crazytiti/Treuil-Handi/code_arduino/simuler le treuil/servo1.png

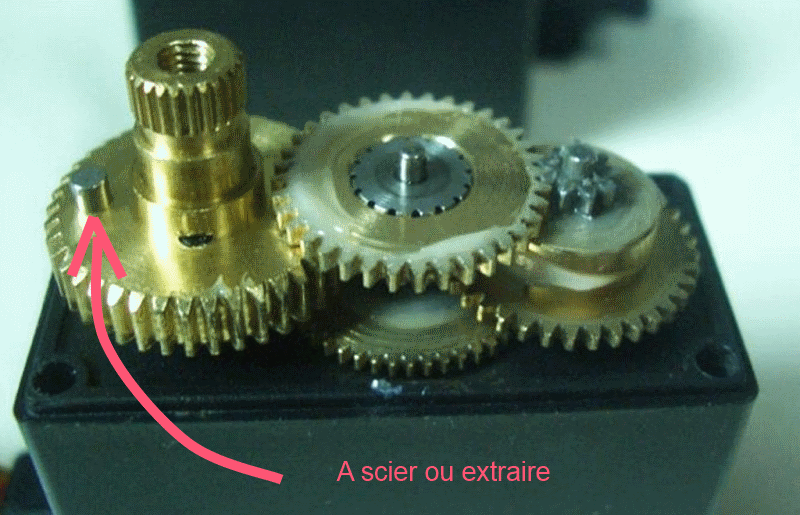
code_arduino/simuler le treuil/servo1.png
