crazytiti/Treuil-Handi/doc/HBridge_exemple.png

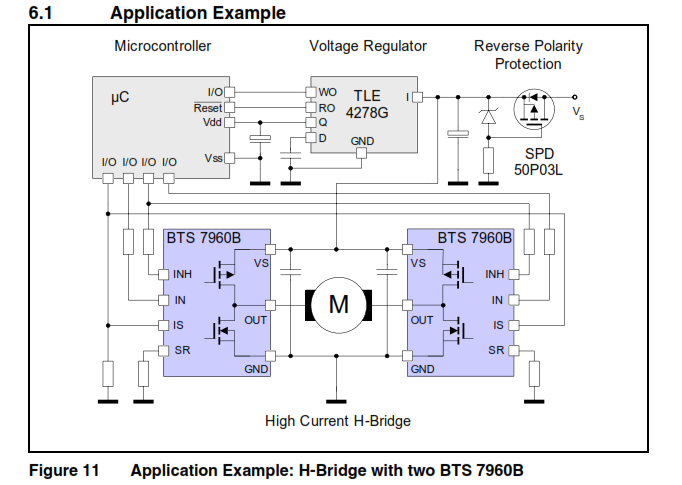
doc/HBridge_exemple.png
