crazytiti/Treuil-Handi/images/FR4.png

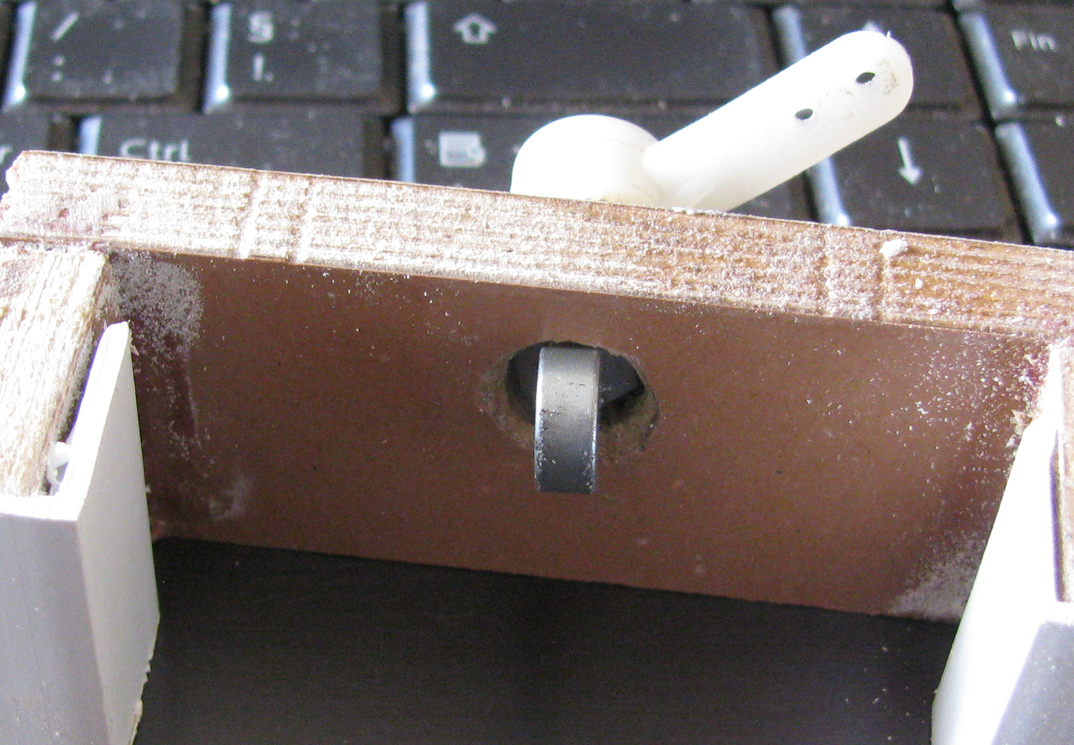
images/FR4.png
