crazytiti/Treuil-Handi/images/FR5.png

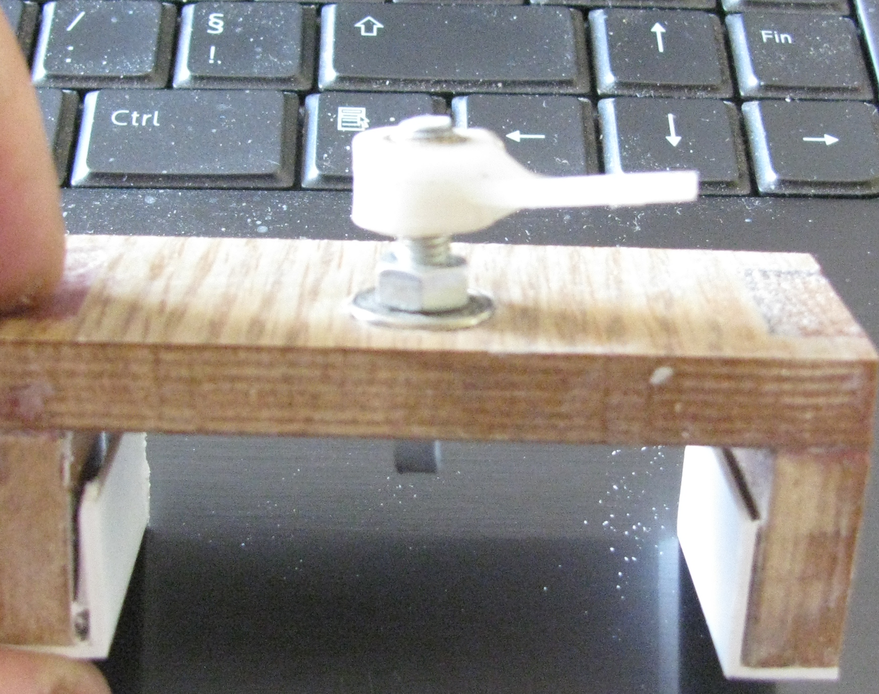
images/FR5.png
