crazytiti/Treuil-Handi/images/proto-board/aimants.jpg

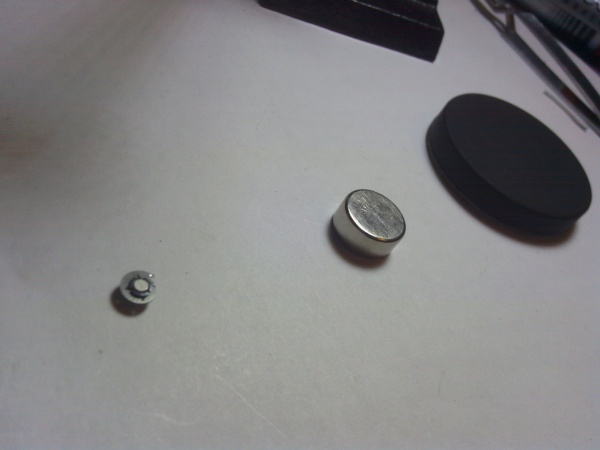
images/proto-board/aimants.jpg
