crazytiti/Treuil-Handi/images/proto-board/capteur_soude.jpg

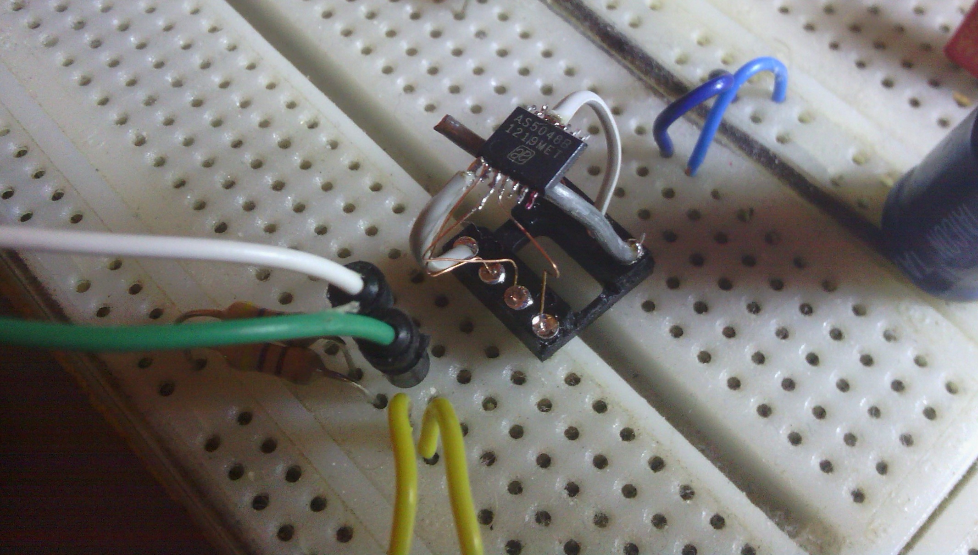
images/proto-board/capteur_soude.jpg
