crazytiti/Treuil-Handi/images/proto-board/it_work.jpg

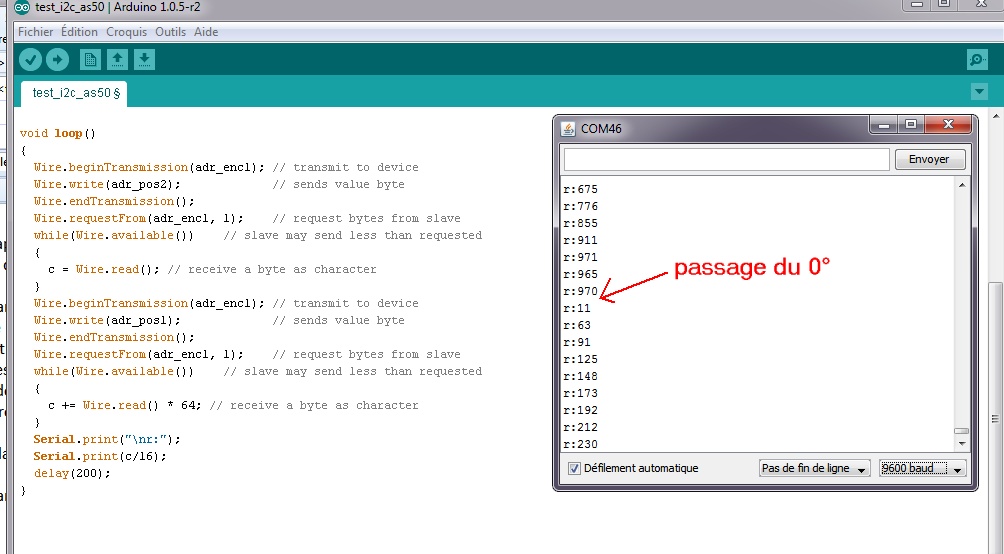
images/proto-board/it_work.jpg
