crazytiti/Treuil-Handi/images/proto-board/potar_proto.jpg

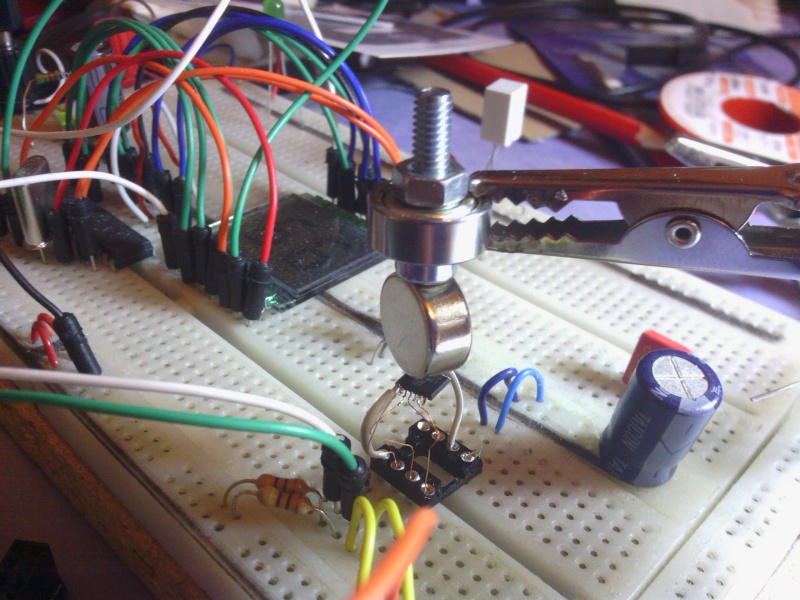
images/proto-board/potar_proto.jpg
