crazytiti/Treuil-Handi/images/proto/proto_treuil_visseuse-1.jpg

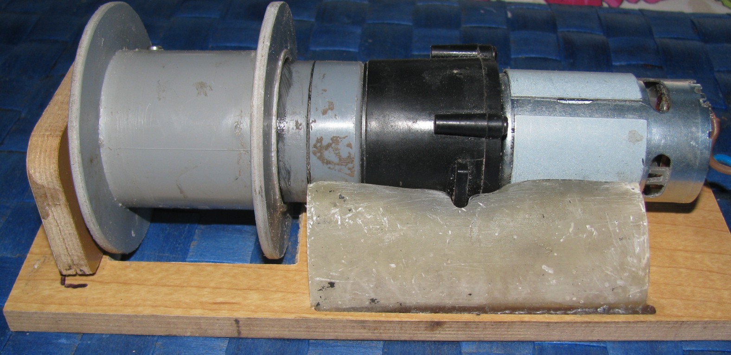
images/proto/proto_treuil_visseuse-1.jpg
