crazytiti/Treuil-Handi/images/proto/proto_treuil_visseuse-2.jpg

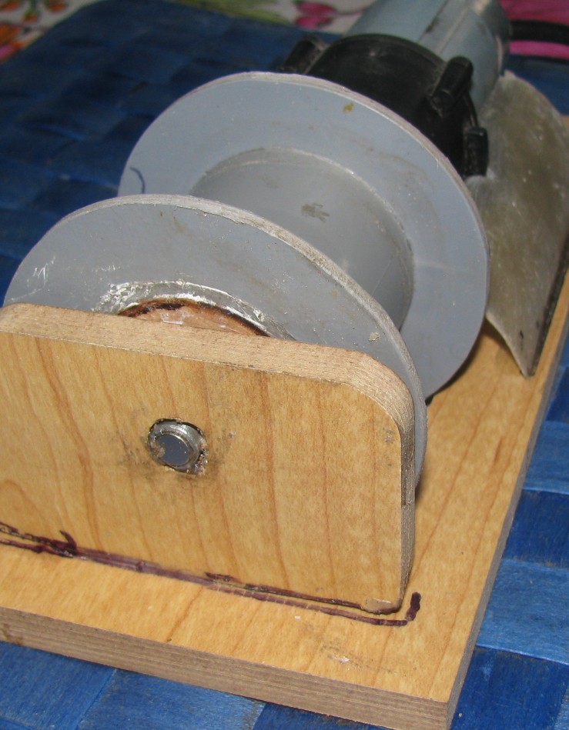
images/proto/proto_treuil_visseuse-2.jpg
