crazytiti/Treuil-Handi/images/proto/treuil.jpg

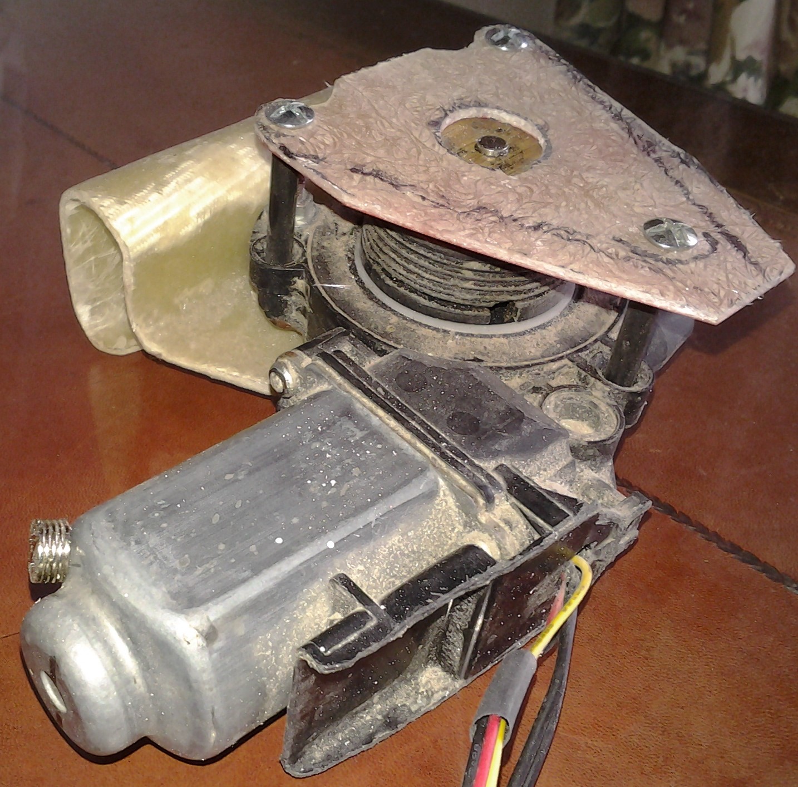
images/proto/treuil.jpg
