crazytiti/Treuil-Handi/schema-pcb/Arduino micro 1.png

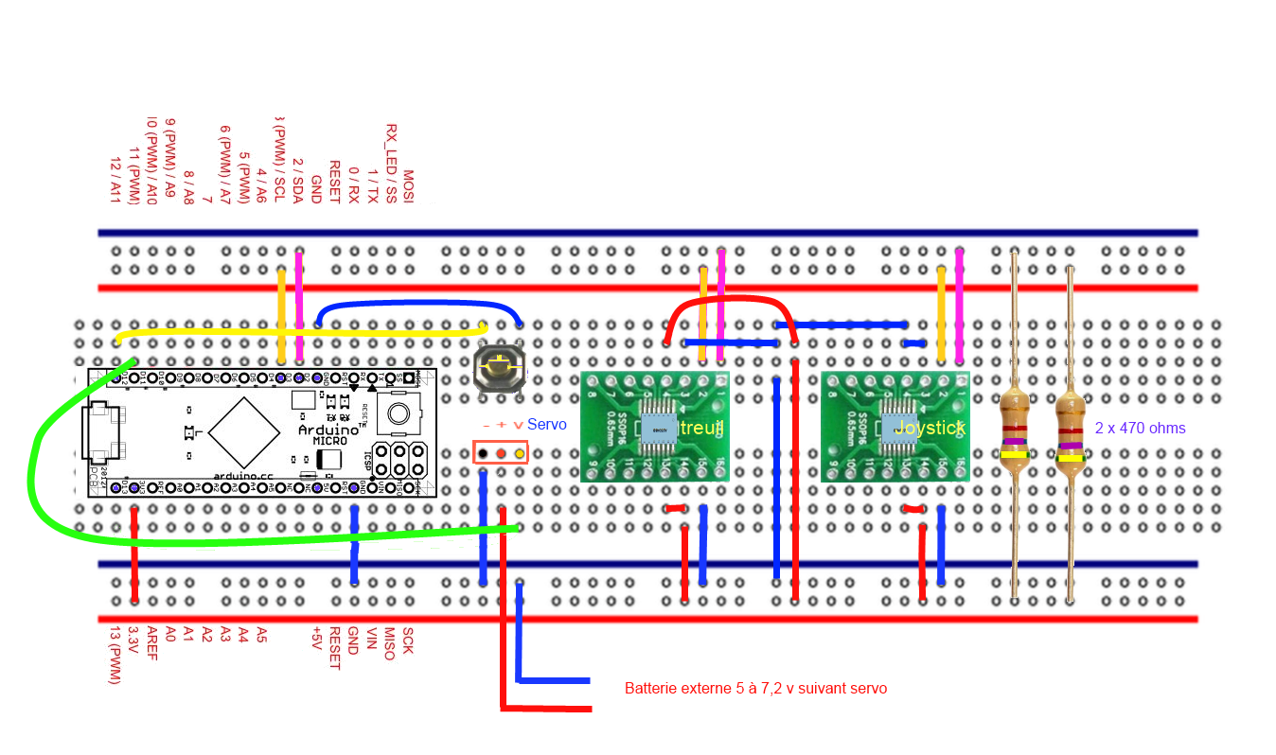
schema-pcb/Arduino micro 1.png
