crazytiti/Treuil-Handi/schema-pcb/Miniji Adapte Donnees Etude ENSTA Rev0 16 Dec.jpg

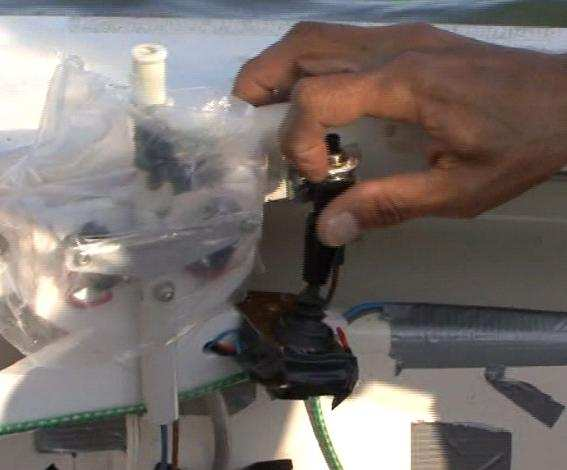
schema-pcb/Miniji Adapte Donnees Etude ENSTA Rev0 16 Dec.jpg
