crazytiti/Treuil-Handi/schema-pcb/treuil_Handi_boutons/planche_boutons.png

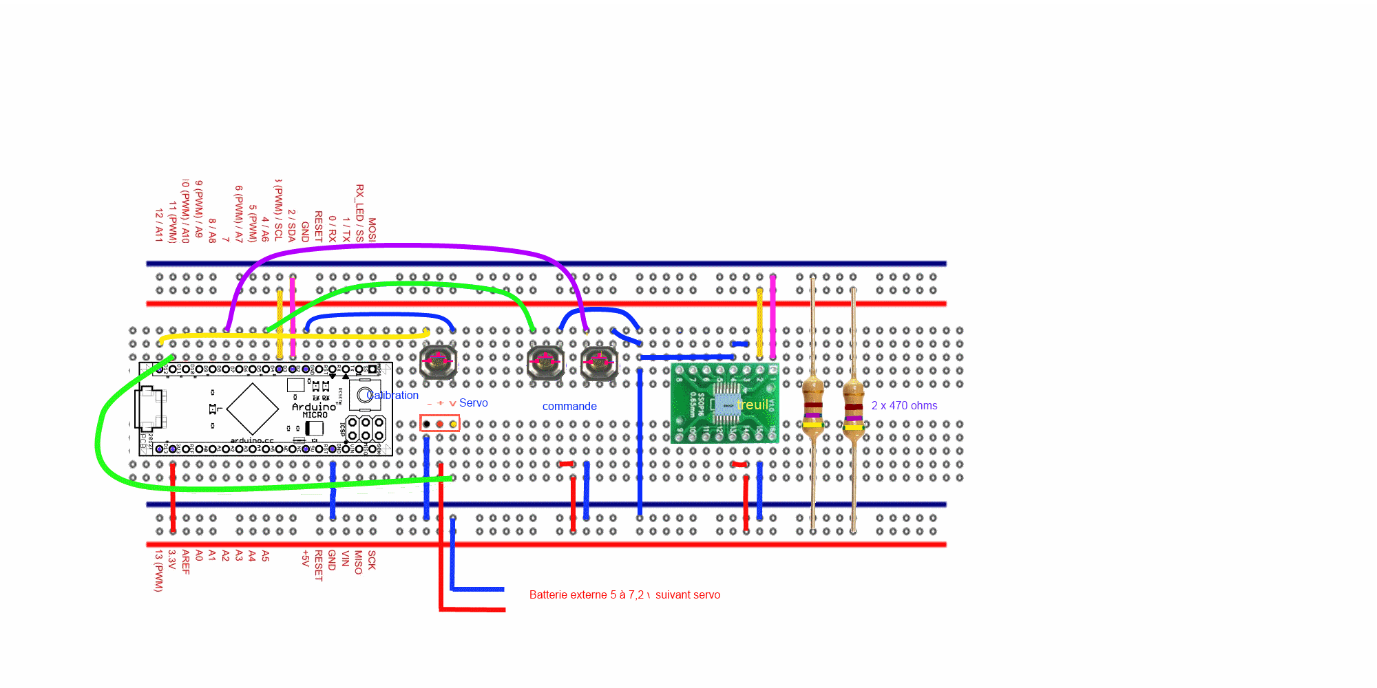
schema-pcb/treuil_Handi_boutons/planche_boutons.png
