crazytiti/Treuil-Handi/BOM/Liste_materiel.odt

Liste du matériel nécessaire :

  Encodeur magnétique pour treuil (multi-tours ou avec reducteur)
    (http://www.megatron.fr/composants/pdf/pdfcod/sf_mab36ap_0701_e02.pdf)
    ~~http://www.megatron.fr/composants/pdf/pdfcod/sf_mab36ap_0701_e02.pdf~~
  Potentiomètre magnétique
    AS5048A ou AS5048B
      http://www.ams.com/eng/Products/Position-Sensors
  Potentiomètre multitours
      Difficulté quant à l'étanchéité
          ~~http://www.banggood.com/10K-Ohm-With-10-Turns-Counting-Dial-Rotary-Potentiometer-Pot-p-911382.html~~
  Carte microcontrôleur
1. Option développement sur arduino et planche à pain
    - Platine arduino nano : http://www.banggood.com/Wholesale-Nano-V3_0-ATmega328P-AU-Microcontroller-Board-With-USB-Cable-p-68535.html (http://www.banggood.com/Wholesale-Nano-V3_0-ATmega328P-AU-Microcontroller-Board-With-USB-Cable-p-68535.html)
    - Planche à pain : http://www.banggood.com/MB102-830-Tie-Points-Solderless-PCB-Breadboard-+-65-Pcs-Jumper-Cables-p-920099.html
    - Utile : http://www.banggood.com/Wholesale-1-Pair-40-Pin-2_54mm-Male-And-Female-SIL-Header-Socket-Row-Strip-PCB-Connector-p-56154.html
2. Option production
    - Platine microcontrôleur http://www.banggood.com/Wholesale-New-Ver-Pro-Mini-ATMEGA328-328p-5V-16MHz-Arduino-Compatible-Nano-Size-p-68534.html
  Interface de puissance du moteur
    - Option avec composants discrets : permet l'adaptation des mosfets de sortie au type de moteur utilisé
    - Option composants intégrant déjà des protections : PCB plus simple.
        http://rs-particuliers.com/WebCatalog/Motor_Driver__BTN7930B_-7532850.aspx
    - Option utilisant un contrôlur de modélisme :
          - Avantage ; tout fait et facile à dépanner puisque c'est toujoursl'étage de puissance qui trinque.
          - Inconvénient : il faut adpter le code à la commande du contrôleur
            http://www.r2hobbies.com/rc-boat-el-water-resistant-110a-esc-electronic-speed-controller.html
            http://www.aliexpress.com/item/320A-Brushed-Brush-Speed-Controller-ESC-RC-Car-Truck-Boat-Reverse-1-8-1-10-1/1599061496.html
  Moteur
    - Récupération de moteur de lève-glace de voiture. dans un gara Exemple Renault Scenic (réduction par vis sans fin doncirréversible.
    - Visseuse : récupération en déchèterie ; inconvénient il est réversible
    - Tournevis électrique ; peu courant sur le marché, moteur peu puissant MAIS équipé d'un dispositif le rendant irreversible dans les deux sens : http://www.aliexpress.com/item/Free-shipping-Mini-200-rpm-6V-Electric-Screwdriver-Cordless-Battery-Power-Screw-driver-Tools-11x-Slot/1106782463.html (http://www.aliexpress.com/item/Free-shipping-Mini-200-rpm-6V-Electric-Screwdriver-Cordless-Battery-Power-Screw-driver-Tools-11x-Slot/1106782463.html). Un chose obligatoire sera de changer de moteur.
