crazytiti/Treuil-Handi/doc/TODO.txt

faire la doc utilisateur (calibration...)
