crazytiti/Treuil-Handi/schema-pcb/R3_micro.sch

## KiCad design schema-pcb/R3_micro.sch (2014-07-03)

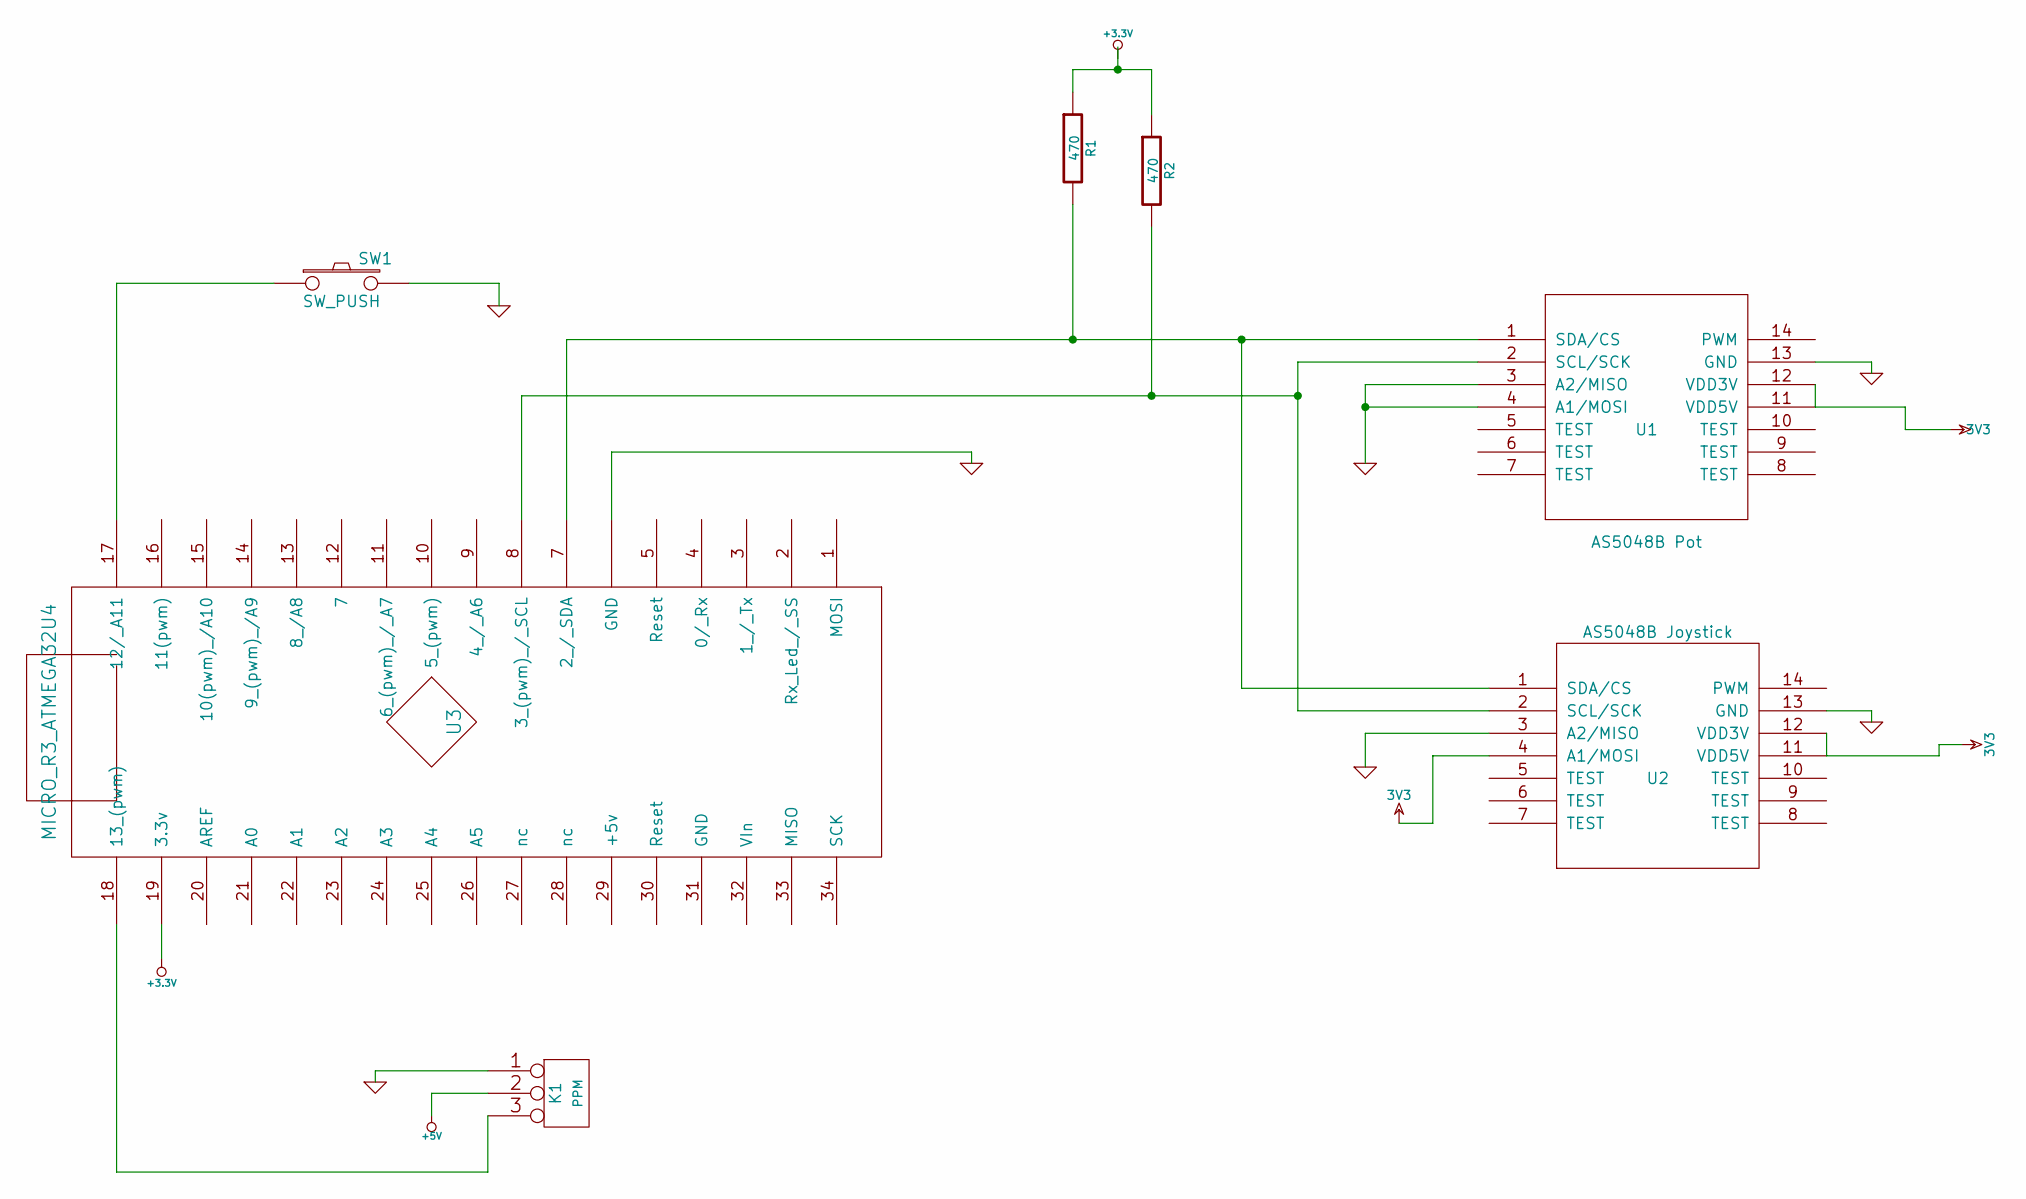
[picture p17: schematic R3_micro.sch]

Parts:
K1: PPM
R1, R2: 470
SW1: SW_PUSH
U1: AS5048B Pot; MODULE
U2: AS5048B Joystick; MODULE
U3: MICRO_R3_ATMEGA32U4

Connections:
3V3: U1.11 (VDD5V), U1.12 (VDD3V), U2.4 (A1/MOSI), U2.11 (VDD5V), U2.12 (VDD3V)
+3.3V: R1.1, R2.1, U3.19 (3.3v)
+5V: K1.2 (PM)
GND: K1.1, SW1.2, U1.3 (A2/MISO), U1.4 (A1/MOSI), U1.13 (GND), U2.3 (A2/MISO), U2.13 (GND), U3.~ (GND)
unnamed: K1.3, U3.18 (13_(pwm))
unnamed: R1.2, U1.1 (SDA/CS), U2.1 (SDA/CS), U3.7 (2_/_SDA)
unnamed: R2.2, U1.2 (SCL/SCK), U2.2 (SCL/SCK), U3.8 (3_(pwm)_/_SCL)
unnamed: SW1.1, U3.17 (12/_A11)
