crazytiti/Treuil-Handi/schema-pcb/treuil-handi.sch

## KiCad design schema-pcb/treuil-handi.sch (2014-08-02)

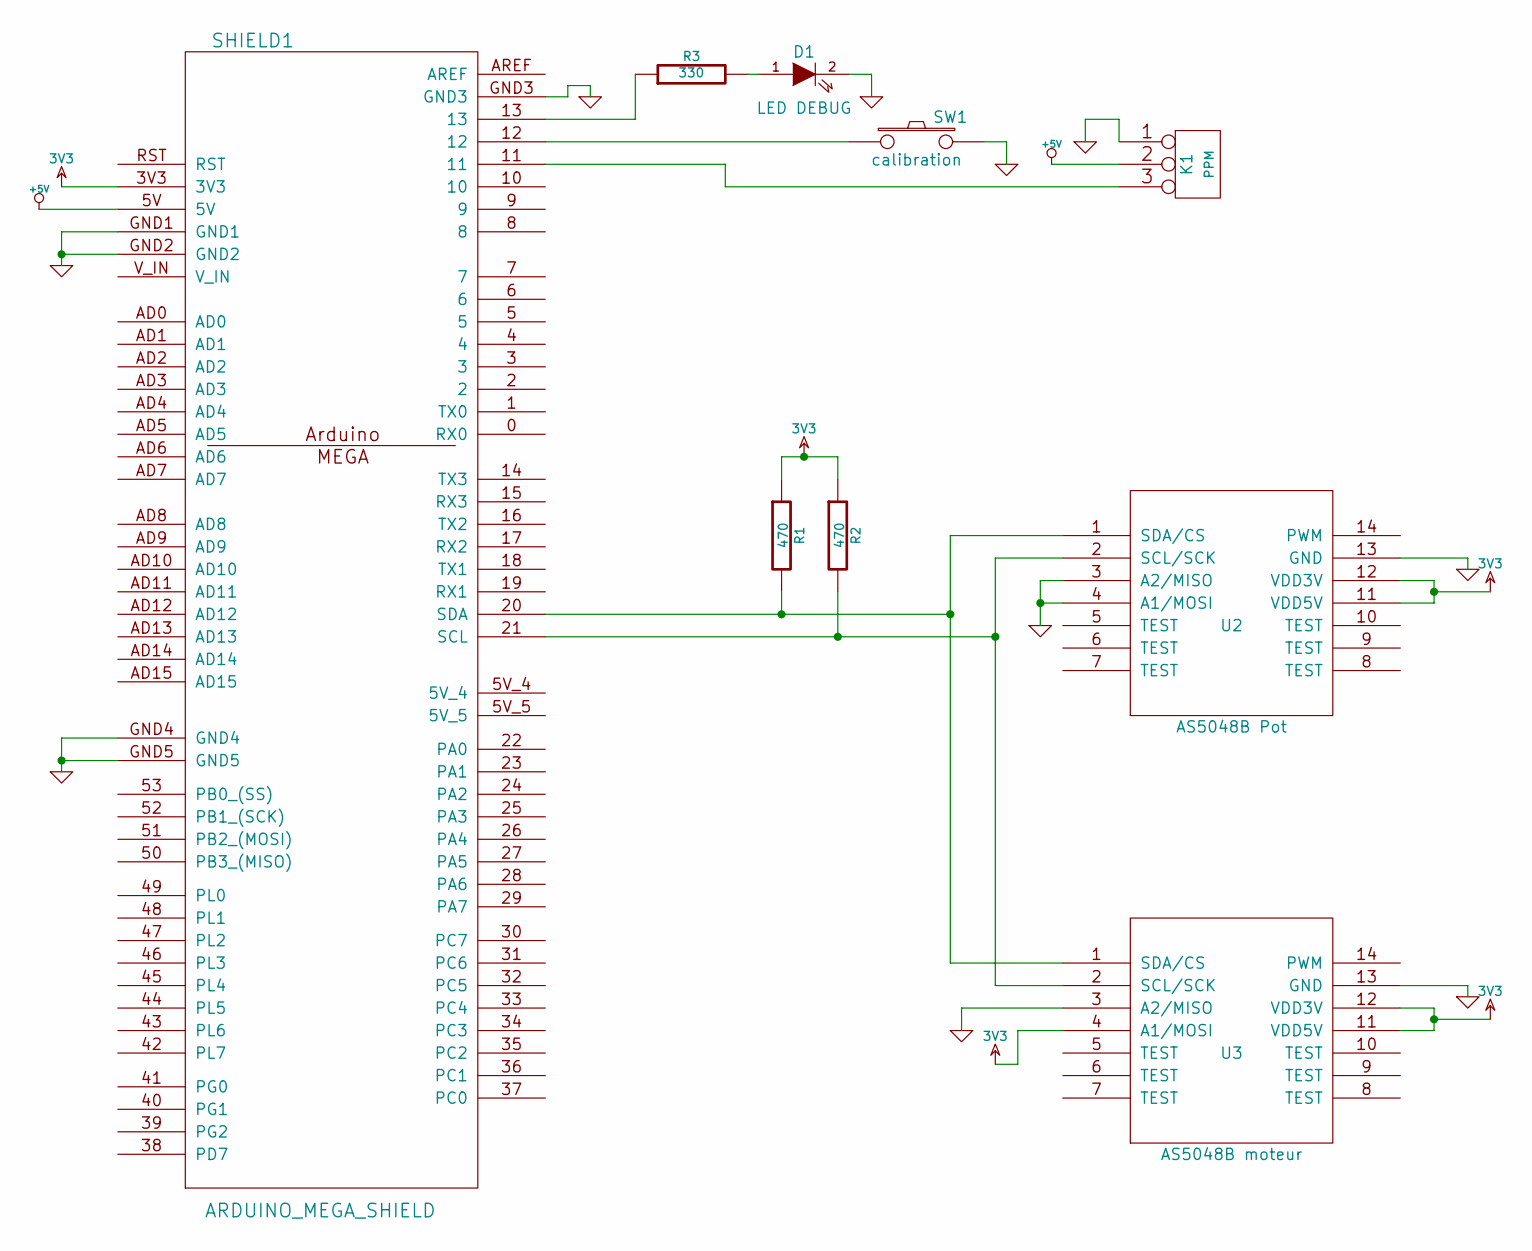
[picture p18: schematic treuil-handi.sch]

Parts:
D1: LED DEBUG
K1: PPM
R1, R2: 470
R3: 330
SHIELD1: ARDUINO_MEGA_SHIELD
SW1: calibration
U2: AS5048B Pot; MODULE
U3: AS5048B moteur; MODULE

Connections:
3V3: R1.1, R2.1, SHIELD1.3V3, U2.11 (VDD5V), U2.12 (VDD3V), U3.4 (A1/MOSI), U3.11 (VDD5V), U3.12 (VDD3V)
+5V: K1.2 (PM), SHIELD1.5V
GND: D1.2 (K), K1.1, SHIELD1.GND1, SHIELD1.GND2, SHIELD1.GND3, SHIELD1.GND4, SHIELD1.GND5, SW1.2, U2.3 (A2/MISO), U2.4 (A1/MOSI), U2.13 (GND), U3.3 (A2/MISO), U3.13 (GND)
unnamed: D1.1 (A), R3.2
unnamed: K1.3, SHIELD1.11
unnamed: R1.2, SHIELD1.20 (SDA), U2.1 (SDA/CS), U3.1 (SDA/CS)
unnamed: R2.2, SHIELD1.21 (SCL), U2.2 (SCL/SCK), U3.2 (SCL/SCK)
unnamed: R3.1, SHIELD1.13
unnamed: SHIELD1.12, SW1.1
