crazytiti/Treuil-Handi/code_arduino/treuil_handi/treuil_handi.ino

//Pour arduino 1.05

#include <Wire.h>
#include <EEPROM.h>
#include <Servo.h> 
#include "fonctions_treuil.h"

#define adr_eeprom_nb_tour_pot  0                  // adresse en eeprom nb de tour du pot
#define adr_eeprom_nb_tour_treuil  4               // adresse en eeprom nb de tour du treuil
#define adr_eeprom_treuil_max  8                   // adresse en eeprom position treuil maxi
#define adr_eeprom_treuil_min  12                  // adresse en eeprom position treuil mini
#define adr_eeprom_pot_max  16                     // adresse en eeprom position potar maxi
#define adr_eeprom_pot_min  20                     // adresse en eeprom position potar mini
#define adr_eeprom_pot_neutre  24                  // adresse en eeprom position potar neutre
#define adr_eeprom_mode  28                        // adresse en eeprom sauvegarde du mode

treuil treuil_1(boutton_pin, adr_eeprom_treuil_max, adr_eeprom_treuil_min,
                adr_eeprom_pot_max, adr_eeprom_pot_min, adr_eeprom_pot_neutre);

void setup()
{
  int tempo_calib;
  Serial.begin(9600);                              // start serial for output
  delay(3000);                                     // pour attendre que l'on ouvre l'afficheur série
  if (debug)
    {Serial.println("Treuil-Handi");}
  treuil_1.init(adr_enc1, adr_eeprom_nb_tour_pot, adr_enc2, adr_eeprom_nb_tour_treuil, moteur_pin, moteur_pwm_pin, moteur_left_pin, moteur_right_pin);
  pinMode(led_pin, OUTPUT);
  treuil_1.moteur_treuil.beep(2);
  treuil_1.moteur_treuil.beep(1);
//---  calibration
  tempo_calib = 0;
  while(tempo_calib < 500)                                  // phase calibration
  {
    if (!digitalRead(boutton_pin))
    {
      while(!digitalRead(boutton_pin));                      // attente relâchement bouton
      delay(tempo_rebond);                                  // anti-rebond
      if (debug)
        Serial.println("calibration");
      treuil_1.calibration();
      tempo_calib = 500;                                    // on sort de la boucle si calibration
    }
    delay(10);
    tempo_calib++;
    if (tempo_calib % 20 == 1)
    {    digitalWrite(led_pin, !digitalRead(led_pin));}     // clignotement de la led pendant toute la durée
  }                                                         // où la calibration peut être déclenchée
//---  fin calibration  
  ee_lit(adr_eeprom_mode, (char*)&treuil_1.mode, 4);  // rappel du mode
  if ((treuil_1.mode != 0) && (treuil_1.mode != 1))   // pour le 1er lancement on ne connait aps l'état de l'eeprom
    {treuil_1.mode = 0;}
  if (treuil_1.mode)
    {digitalWrite(led_pin, HIGH);}
  else
    {digitalWrite(led_pin, LOW);}
  treuil_1.moteur_treuil.beep(2);
}

void loop()
{
  float r,t;  
  int i;
  while(1) //marche normale
  {
    treuil_1.marche();
    if (!digitalRead(boutton_pin))
    {
      delay(500);
      treuil_1.mode = 1- treuil_1.mode;
      ee_ecrit(adr_eeprom_mode, (char*)&treuil_1.mode, 4);  // sauvegarde du mode
      if (!treuil_1.mode)                                   // clignote 1 fois pour mode vitesse,
      {                                                     //  2 fois pour mode position
        digitalWrite(led_pin, LOW);
        delay(200);
        digitalWrite(led_pin, HIGH);
      }
      else
      {
        digitalWrite(led_pin, LOW);
        delay(200);
        digitalWrite(led_pin, HIGH);
        delay(200);
        digitalWrite(led_pin, LOW);
        //delay(200);
        //digitalWrite(led_pin, HIGH);                      // on laisse éteint pour le mode position
      }
    }    
    if (i > 250 && debug)
    {
      r = treuil_1.c_potar.get_tour();
      t = treuil_1.c_treuil.get_tour();
      Serial.print("\nr:");
      Serial.print(r);
      Serial.print(" t:");
      Serial.print(t);     
      Serial.print(" min:");
      Serial.print(treuil_1.pot_min);
      Serial.print(" max:");
      Serial.print(treuil_1.pot_max);
      Serial.print(" nt:");
      Serial.print(treuil_1.pot_neutre);
      Serial.print(" t_mn:");
      Serial.print(treuil_1.treuil_min);
      Serial.print(" t_mx:");
      Serial.print(treuil_1.treuil_max);
      i = 0;
    }
    i++;
  }
}
