crazytiti/Treuil-Handi/code_arduino/treuil_handi/fonctions_treuil.cpp

#include "fonctions_treuil.h"

treuil::treuil(char button, char adr_treuil_max, char adr_treuil_min,
char adr_joy_max, char adr_joy_min, char adr_joy_neutre)
{
  button_pin = button;                                           // pin bouton
  adr_ee_treuil_max = adr_treuil_max;
  adr_ee_treuil_min = adr_treuil_min;
  adr_ee_joy_max = adr_joy_max;
  adr_ee_joy_min = adr_joy_min;
  adr_ee_joy_neutre = adr_joy_neutre;
  mode = 0;                                                      // mode vitesse par défaut
}

void treuil::calibration (void)
{
  // min et max du treuil
  c_treuil.raz();
  moteur_treuil.marche(calib_speed);                         // moteur avant lent
  if (debug)
  {
    Serial.println("En avant lent vers fin de course");
    Serial.println(" Appui sur le bouton quand on y est. ");
  }
  while (digitalRead(button_pin))                  // attend tant que le bouton n'est pas appuyé
  {                                                // le treuil tourne pendant ce temps
    treuil_max = c_treuil.get_tour();              // indispensable pour enregistrer le nb de tours
  }
  moteur_treuil.marche(0);                         // arrêt moteur
  if (debug)
  {
    Serial.println("Appui sur le bouton");
  }

  while (!digitalRead(button_pin));                // attend le relâchement du bouton
  delay(tempo_rebond);                             //anti-rebond
  //sauvegarde position
  treuil_max = c_treuil.get_tour();                          
  if (debug)
  {
    Serial.print("treuil_max = ");
    Serial.println(treuil_max);
    Serial.println("");
  }
  ee_ecrit(adr_ee_treuil_max, (char*)&treuil_max, 4);

  moteur_treuil.marche(-calib_speed);                        // moteur arrière lent
  while (digitalRead(button_pin))                  // attend tant que le bouton n'est pas appuyé
  {
    treuil_min = c_treuil.get_tour();              // indispensable pour enregistrer le nb de tours
  }
  moteur_treuil.marche(0);                         // arrêt moteur
  while (!digitalRead(button_pin));                // attend tant que le bouton est appuyé
  delay(tempo_rebond);                             // anti-rebond
  // sauvegarde position
  treuil_min = c_treuil.get_tour();  
  if (debug)
  {
    Serial.print("treuil_min = ");
    Serial.println(treuil_min);
    Serial.println("");  
  }
  ee_ecrit(adr_ee_treuil_min, (char*)&treuil_min, 4);

  // min et max joystick
  if (debug)
  {
    Serial.println("Calibration du joystick");
    Serial.println("");
  }
  c_potar.raz();
  pot_max = -10;
  pot_min = 10;
  pot_neutre = 0;
  float act_pos;
  if (debug)
  {
    Serial.println("Faire bouger le manche du joystick plusieurs fois du minimum au maximum");
    Serial.println("");
    Serial.println("Puis le mettre au neutre avant d'appuyer sur le bouton");
    Serial.println("");
  }
  while (digitalRead(button_pin))                 // tant qu'on appuie pas sur le bouton
  {
    act_pos = c_potar.get_tour();
    act_pos += c_potar.get_tour();
    act_pos += c_potar.get_tour();
    act_pos += c_potar.get_tour();
    act_pos = act_pos /4;
    if (act_pos > pot_max){
      pot_max = act_pos;
    }
    if (act_pos < pot_min){
      pot_min = act_pos;
    }
  }
  // on a les valeurs max et min et on sort de la boucle par appui
  // sur le bouton. Au préalable bien ramener le joystick au neutre.
  pot_neutre = c_potar.get_tour();
  pot_neutre += c_potar.get_tour();
  pot_neutre += c_potar.get_tour();
  pot_neutre += c_potar.get_tour();
  pot_neutre = pot_neutre / 4;              // moyenne 
  //sauvegarde les 3 positions en eeprom
  ee_ecrit(adr_ee_joy_max, (char*)&pot_max, 4);
  ee_ecrit(adr_ee_joy_min, (char*)&pot_min, 4);
  ee_ecrit(adr_ee_joy_neutre, (char*)&pot_neutre, 4);
  delay(tempo_rebond);                      //anti-rebond
}



void treuil::init(char adr_encp, char adr_eeprom_nb_tour_pot, char adr_enct, char adr_eeprom_nb_tour_treuil, char moteur,char moteur_pwm, char moteur_left, char moteur_right)
{
  c_potar.set_compteur(adr_encp, adr_eeprom_nb_tour_pot);        // récupère la position du potar en eeprom
  c_treuil.set_compteur(adr_enct, adr_eeprom_nb_tour_treuil);    // récupère la position du treuil en eeprom
  pinMode(button_pin, INPUT_PULLUP);                             // pull up du boutton
  c_potar.init();                                                // init des 2 compteurs potar et treuil
  c_treuil.init();
  moteur_treuil.init(moteur, moteur_pwm, moteur_left, moteur_right);          // init du moteur
  moteur_treuil.marche(0);                                       // mise à l'arrêt du moteur
  if (debug)
  {
    Serial.println("Servo immobile\n");
  }

  // initialisation des différentes constantes de calibration   
  delay(1000);
  last_speed = 0;                                                // init à 0 en mode position
  last_time = millis();                                          // mémorisation de l'heure
  ee_lit(adr_ee_treuil_max, (char*)&treuil_max, 4);              // récupère en eeprom toutes les valeurs
  ee_lit(adr_ee_treuil_min, (char*)&treuil_min, 4);
  ee_lit(adr_ee_joy_max, (char*)&pot_max, 4);
  ee_lit(adr_ee_joy_min, (char*)&pot_min, 4);
  ee_lit(adr_ee_joy_neutre, (char*)&pot_neutre, 4);
}


void treuil::marche()
{
  float pot_value;                                              // valeur potentiomètre
  pot_value = c_potar.get_tour();
  // calcul la valeur de déplacement en + - 100%
  if (pot_value >= pot_neutre)                                  // déplacement positif
  {
    pot_value = (pot_value - pot_neutre) * 100 / (pot_max - pot_neutre);
  }
  else                                                          // déplacement négatif
  {
    pot_value = (pot_value - pot_neutre) * 100 / (pot_neutre - pot_min);
  }  
  pot_value = pot_value * (100 / (100- zone_max));              // expansion de la dynamique du potar en fonction de
  //  la marge par rapport au maxi
  if (pot_value > 100)                                          // bornage
  {
    pot_value = 100;
  }
  if (pot_value < -100)
  {
    pot_value = -100;
  }
  switch(mode){
  case 0:                     // mode vitesse
    if (pot_value > zone_neutre)                                // marche avant
    {
      if (c_treuil.get_tour() < treuil_max)
      {
        moteur_treuil.marche(pot_value);
      }
      else
      {
        moteur_treuil.marche(0);
      }
    }
    else if (pot_value < - zone_neutre)                         // marche arrière
    {
      if (c_treuil.get_tour() > treuil_min)
      {
        moteur_treuil.marche(pot_value);
      }
      else
      {
        moteur_treuil.marche(0);
      }
    }    
    else  //arret
    {
      moteur_treuil.marche(0);
    }
    break;
  case 1:                                                      // mode position, fréquence de rafraichissement 10ms (100hz)
    if ((millis() - last_time) < 10)                           // on sort si 10ms ne se sont pas écoulées
    {
      break;
    }
    last_time = millis();                                      // mémorisation de l'heure
    //calcule de la position actuelle du treuil en % (de - 100 à +100)
    float treuil_pos = c_treuil.get_tour();
    treuil_pos = (treuil_pos - treuil_min) *200 / (treuil_max - treuil_min);
    treuil_pos = treuil_pos - 100;    //"centrage" à 0%
    //detection d'une nouvelle consigne de position
    if ((pot_value > last_pos + zone_neutre_pos) | (pot_value < last_pos - zone_neutre_pos))
    {
      last_pos = pot_value;
      pos_atteint = 0;                                           // r-a-z
      last_dir = last_pos - treuil_pos;                          //detection du sens
    }
    if (treuil_pos < last_pos)
    {
      last_speed = last_speed + 100.00 / (ramp_speed / 10.00);   // accélération suivant rampe
      if (last_speed > 100)
      {
        last_speed = 100;
      }
      if (last_speed < min_speed)
      {
        last_speed = min_speed;
      }
    }
    else if (treuil_pos > last_pos)
    {
      last_speed = last_speed - 100.00 / (ramp_speed / 10.00);   // accélération suivant rampe
      if (last_speed < -100)
      {
        last_speed = -100;
      }
      if (last_speed > -min_speed)
      {
        last_speed = -min_speed;
      }
    }
    else
    {
      last_speed = 0;
    }
    //--------------gestion du jeux mecannique -------
    
    if (last_dir > 0 & pos_atteint == 0)
    {
      if (treuil_pos >= last_pos)                                // consigne depasse
      {
        pos_atteint = 1;
      }
    }
    else if (last_dir < 0 & pos_atteint == 0)
    {
      if (treuil_pos <= last_pos)                                // consigne depasse
      {
        pos_atteint = 1;
      }
    }   
    if ((treuil_pos > last_pos + jeu_mini) & pos_atteint)       // jeu depasse
    {
      pos_atteint = 0;                                          // reactivation
      last_dir = -1;                                             //detection du sens
    }
    if ((treuil_pos < last_pos - jeu_mini) & pos_atteint)       // jeu depasse
    {
      pos_atteint = 0;                                          // reactivation
      last_dir = 1;                                            //detection du sens
    }
    
    if (pos_atteint == 1)
    {
      last_speed = 0;
    }    
    // -----------gestion des butées ------
    if (last_speed > 0)
    {
      if (c_treuil.get_tour() >= treuil_max)                    // max atteint => arrêt
      {
        last_speed = 0;
      }
    }
    else if (last_speed < 0)
    {
      if (c_treuil.get_tour() <= treuil_min)                   // min atteint => arrêt
      {
        last_speed = 0;
      }
    }
    moteur_treuil.marche(last_speed);                          // envoi de la commande au moteur
    break;
  }
}
