crazytiti/Treuil-Handi/code_arduino/treuil_Handi_boutons/compteur.h

#include "AS5048.h"
#include "eeprom.h"

class compteur
{
public:
  compteur(void);
  void set_compteur(char adr_source, int adr_eeprom_source);  // adresse I2C et adresse de sauvegarde
  void init();                                        // init
  void raz();                                         // remise à 0
  float get_tour();                                   // détecte la position et compte le nombre de tours
private:  
  signed int nb_tour;
  signed int pos, old_pos;
  char adr;                                           // adresse I2C
  int adr_eeprom;
};
