crazytiti/Treuil-Handi/(commit log)

2014-06-17 couleur de lien
2014-06-26 code_proto + photo proto
    code de lecture d'angle sur as5048 en I2C
2014-06-28 mise en forme + fonctions
    compte le nb de tour + sauvegarde en eeprom
2014-06-30 commande par PPM + schema + lib kicad
    [treuil-handi.sch]
2014-06-30 calibration + classement des includes
2014-07-02 ajout R pull ups i2c + photo proto
    [treuil-handi.sch]
2014-07-03 Rajout lib et schema pour arduino micro r3
    [R3_micro.sch, treuil-handi.sch]
2014-07-03 maj des TODO et de la page de présentation
2014-08-02 maj du schema, doc I2C
    [treuil-handi.sch]
2014-08-02 correction bug + modification vitesse I2C pour cable de 2m
    bug de lecture position capteur pour debug même si debug dsct.
    [AS5048.cpp, treuil_handi.ino]
2014-08-02 modification du servo
2014-08-02 planche avec arduino micro
2014-08-02 correction couleur resistance
2014-08-03 Adaptation fr
    Valeur pour mon servo, et mise en page des commentaires avec ajout
    d'autres pour détailler
2014-08-05 led eteinte pour impulsionel
2014-08-05 retour des mise en pages + led eteinte pour impulsionel
2014-08-05 ajout video de démo
2014-08-06 changement de mode dans todo
2014-08-18 commande PWM
2014-08-27 modification compatibilite module BTS
    mode 3 fils : PWM / mosfet gauche / mosfet droit
2014-09-03 ajout image de treuil avec support
2014-09-08 externalisation des config + compensation de jeux + correction bug dans mode position
    [config.h, fonctions_treuil.cpp, fonctions_treuil.h, moteur.cpp, treuil_handi.ino]
2014-10-16 suppression d'un bout de code de dbug
